e-hallie/Shoot_the_balloons/20251227_142821.jpg

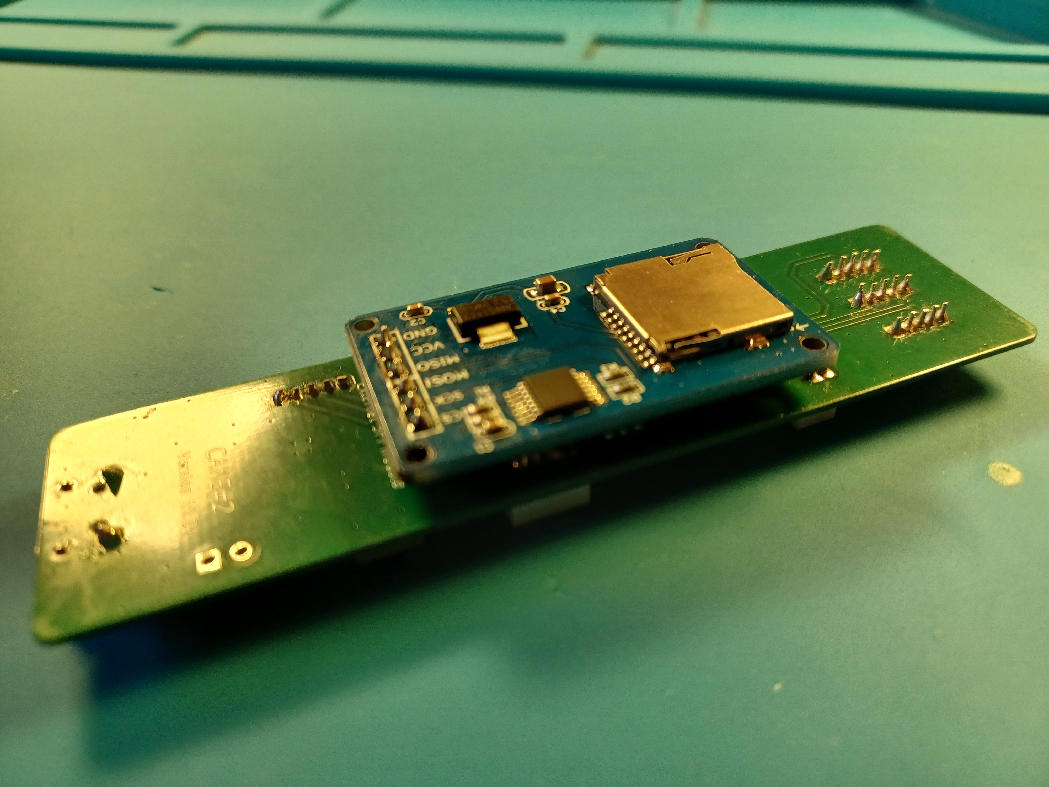
20251227_142821.jpg
