e-hallie/Shoot_the_balloons/Shoot_the_Balloons.jpg

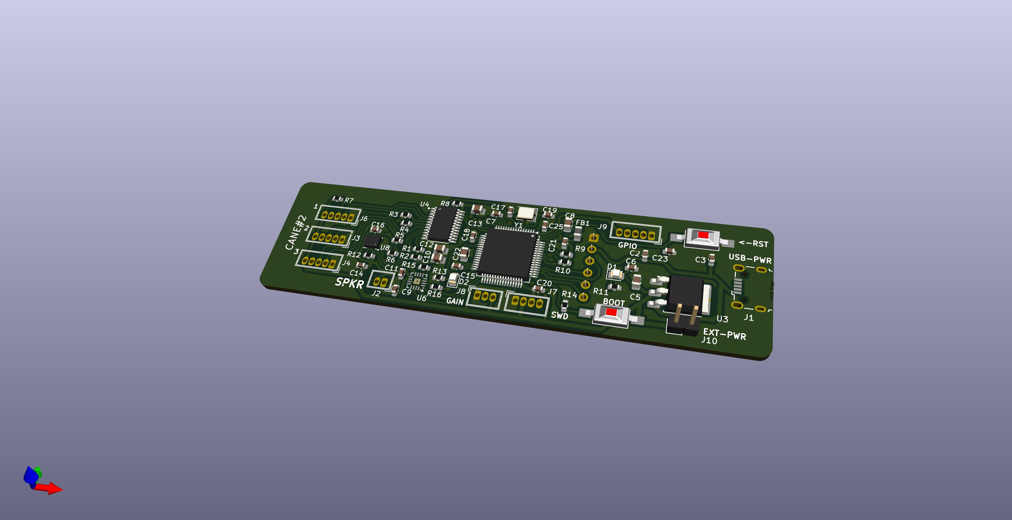
Shoot_the_Balloons.jpg
