e-hallie/Shoot_the_balloons/Schema_ballloon_shooter.pdf

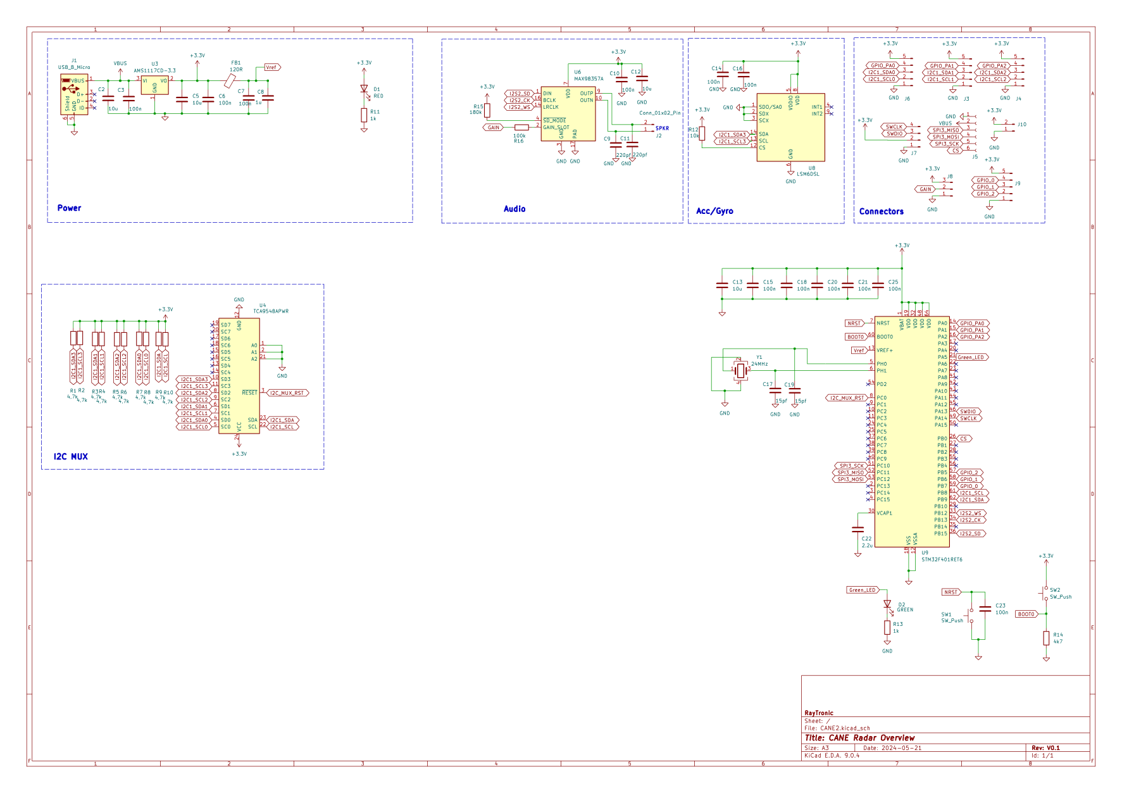
[picture p3: figure]
