e-hallie/Shoot_the_balloons/20251227_134559.jpg

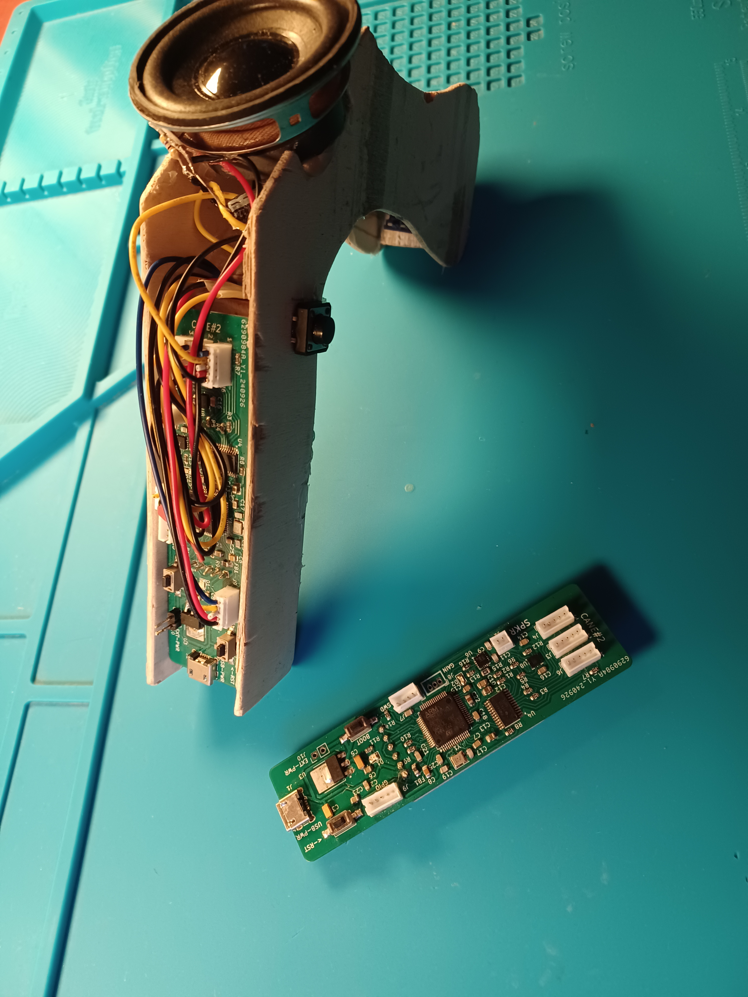
20251227_134559.jpg
