e-hallie/Shoot_the_balloons/20251227_134629.jpg

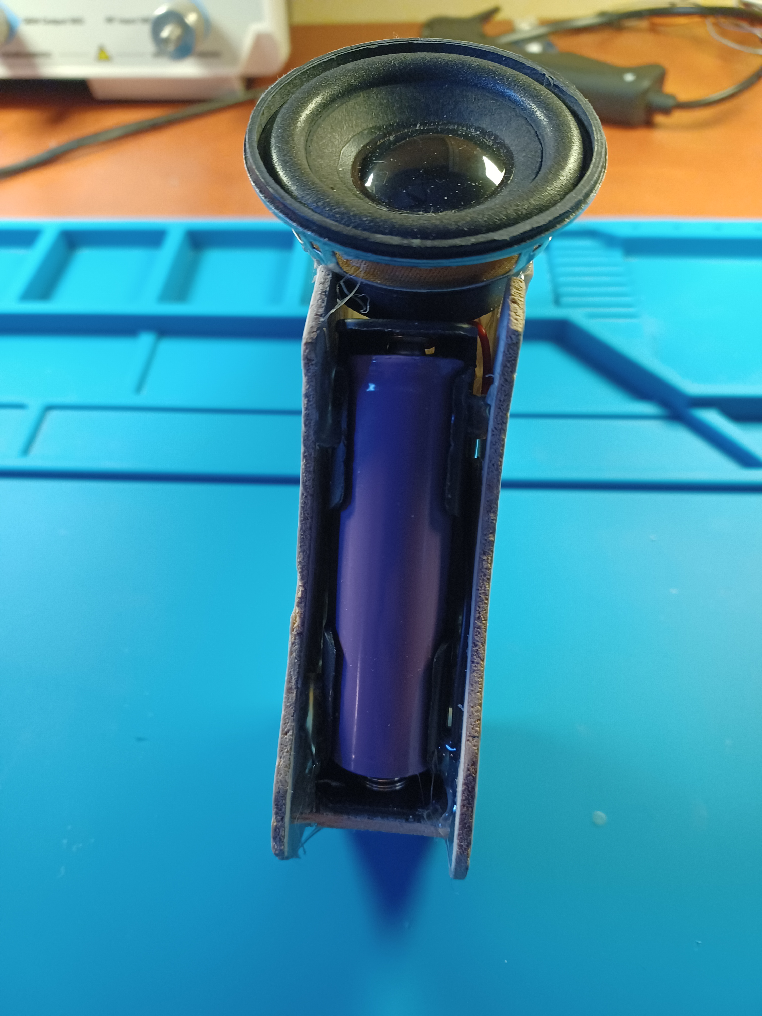
20251227_134629.jpg
