e-hallie/Shoot_the_balloons/20251227_134924.jpg

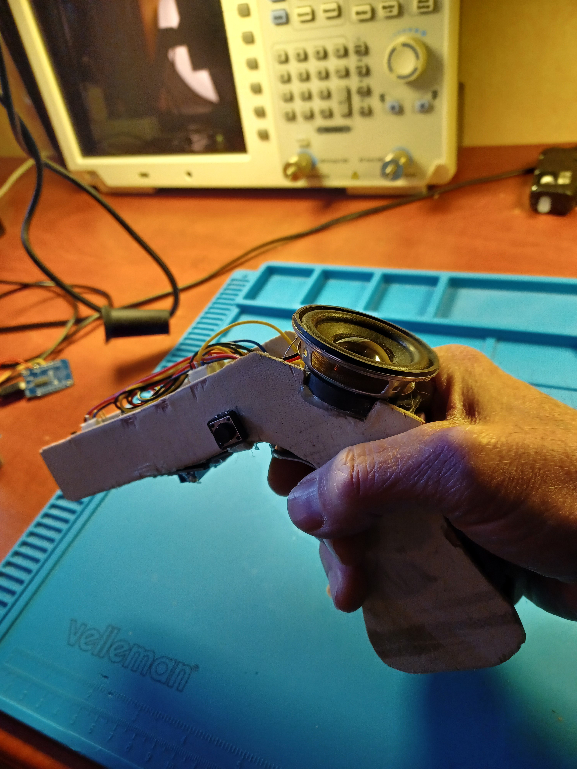
20251227_134924.jpg
