e-hallie/Shoot_the_balloons/main.h

#define I2C_MUX_RST_Pin GPIO_PIN_0
#define I2C_MUX_RST_GPIO_Port GPIOC
#define GPIO_PA1_Pin GPIO_PIN_1
#define GPIO_PA1_GPIO_Port GPIOA
#define GPIO_PA2_Pin GPIO_PIN_2
#define GPIO_PA2_GPIO_Port GPIOA
#define Green_LED_PA5_Pin GPIO_PIN_5
#define Green_LED_PA5_GPIO_Port GPIOA
#define SD_CS_PIN_Pin GPIO_PIN_0
#define SD_CS_PIN_GPIO_Port GPIOB
#define GPIO_2_via_uart_Pin GPIO_PIN_5
#define GPIO_2_via_uart_GPIO_Port GPIOB
