e-hallie/Shoot_the_balloons/(commit log)

2025-12-27 Virtuele Ballonnenschieter
    Virtuele Ballonnenschieter
    Een audiogame voor visueel gehandicapte spelers, ontwikkeld op de STM32F401RET6 microcontroller.
    Beschrijving
    De Virtuele Ballonnenschieter is een schietspel waarbij spelers met behulp van audio-feedback virtuele ballonnen moeten raken. Het spel is speciaal ontworpen voor mensen met een visuele beperking en maakt gebruik van:
    3D audio-feedback via een piezo buzzer (toonhoogte geeft afstand tot ballon aan)
    Tactiele feedback via een vibration motor (trillen wanneer je op de ballon richt)
    Gesproken instructies via WAV-bestanden op SD-kaart
    [main.c, main.h]
2025-12-27 Enhance README with comprehensive game details
    Expanded README with detailed game description, hardware components, wiring diagram, gameplay instructions, audio feedback, configuration parameters, SD card file requirements, building instructions, sensor orientation, and version history.
2026-01-19 KALMAN filter toegevoegd.
    Kalman filter gebruikt voor fusie gyro en Acceleratie.
2026-01-19 Update print statement to say 'Goodbye World'
2026-01-19 Tekstuele aanpassing
    Added version 3.3 details including Kalman filter implementation.
