e-hallie/Shoot_the_balloons/(notices)

Notices in the files:
main.h:
Copyright (c) 2025 STMicroelectronics.
All rights reserved.
This software is licensed under terms that can be found in the LICENSE file
