e-hallie/Shoot_the_balloons/20251227_135410.jpg

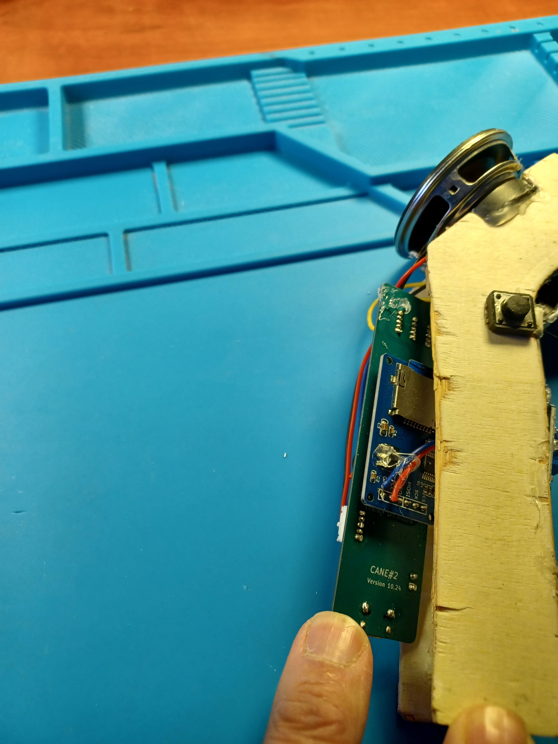
20251227_135410.jpg
